ChrisChrisLoLo/bancouver40/firmware/README.md

# Firmware
This is the default firmware used for the bancouver40. It comes with the [TypeBeastXDPlus Home Edition layout](https://github.com/ChrisChrisLoLo/TypeBeastXDPlus) pre-installed.

If you wish to customize the layout, you can find the QMK source code here: https://github.com/ChrisChrisLoLo/qmk_firmware/tree/bancouver40/keyboards/sporewoh/bancouver40

# Vial
Please use the hex files labelled `vial`. You can find the source files of the vial configuration code here: https://github.com/ChrisChrisLoLo/vial-qmk/tree/sporewoh/keyboards/sporewoh

# QMK Toolbox
When using the vial images via QMK Toolbox, please press the reset button, then press `Clear EEPROM` before clicking on `Flash`. Your keyboard might otherwise not be responsive (but can still be reflashed and retried again).

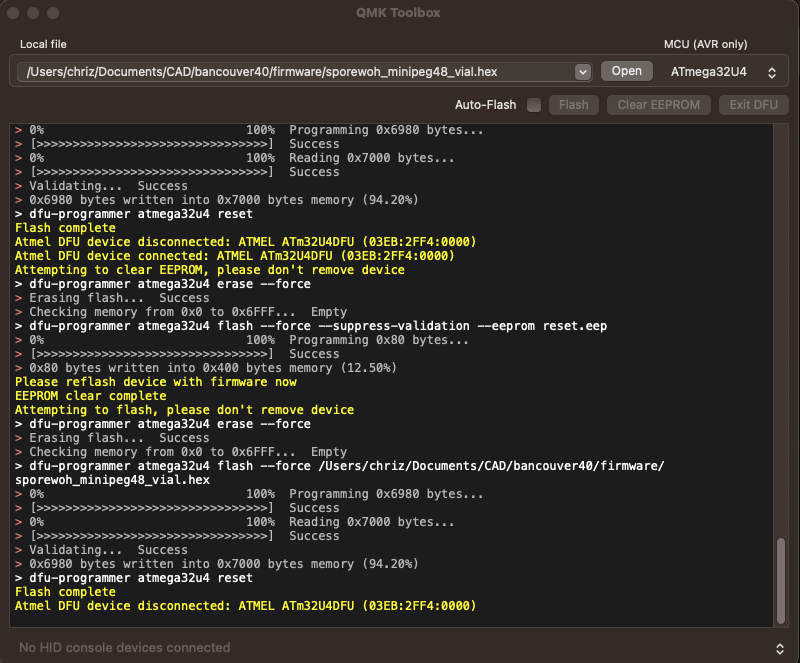
[picture p1: images/Screenshot 2023-12-05 at 7.41.32 PM.png]
image illustrating how to use QMK Toolbox
