ChrisChrisLoLo/bancouver40/images/PXL_20221205_012230895-01.jpeg

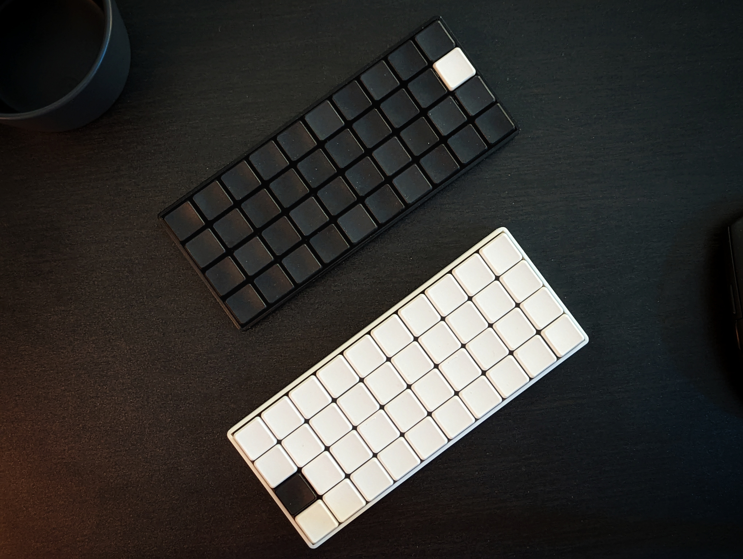
images/PXL_20221205_012230895-01.jpeg
