ChrisChrisLoLo/bancouver40/images/PXL_20221205_012951007-01.jpeg

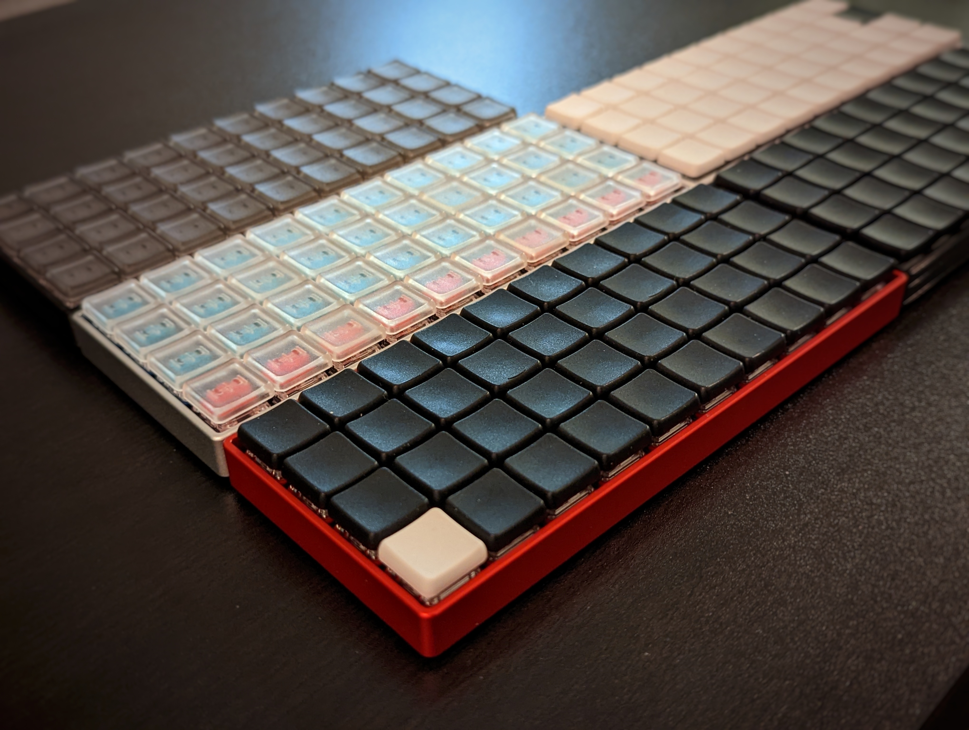
images/PXL_20221205_012951007-01.jpeg
