ChrisChrisLoLo/bancouver40/images/PXL_20221205_015210392-01.jpeg

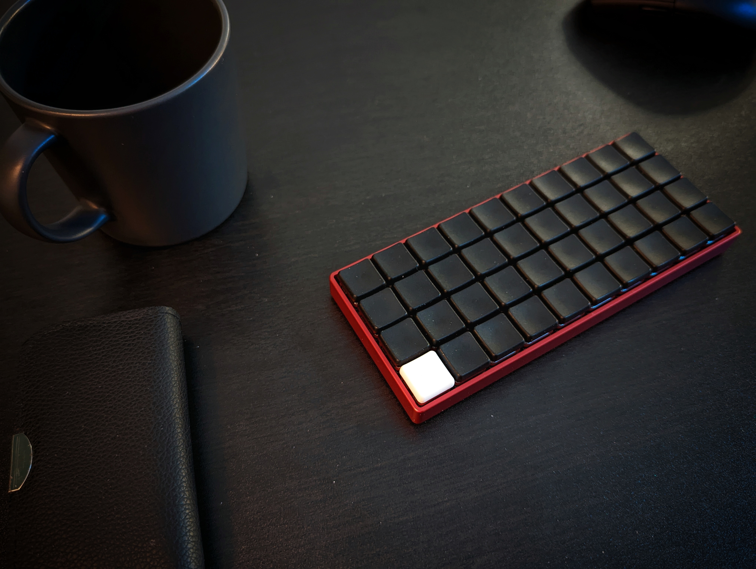
images/PXL_20221205_015210392-01.jpeg
