ChrisChrisLoLo/bancouver40/images/PXL_20231022_023334208.jpg

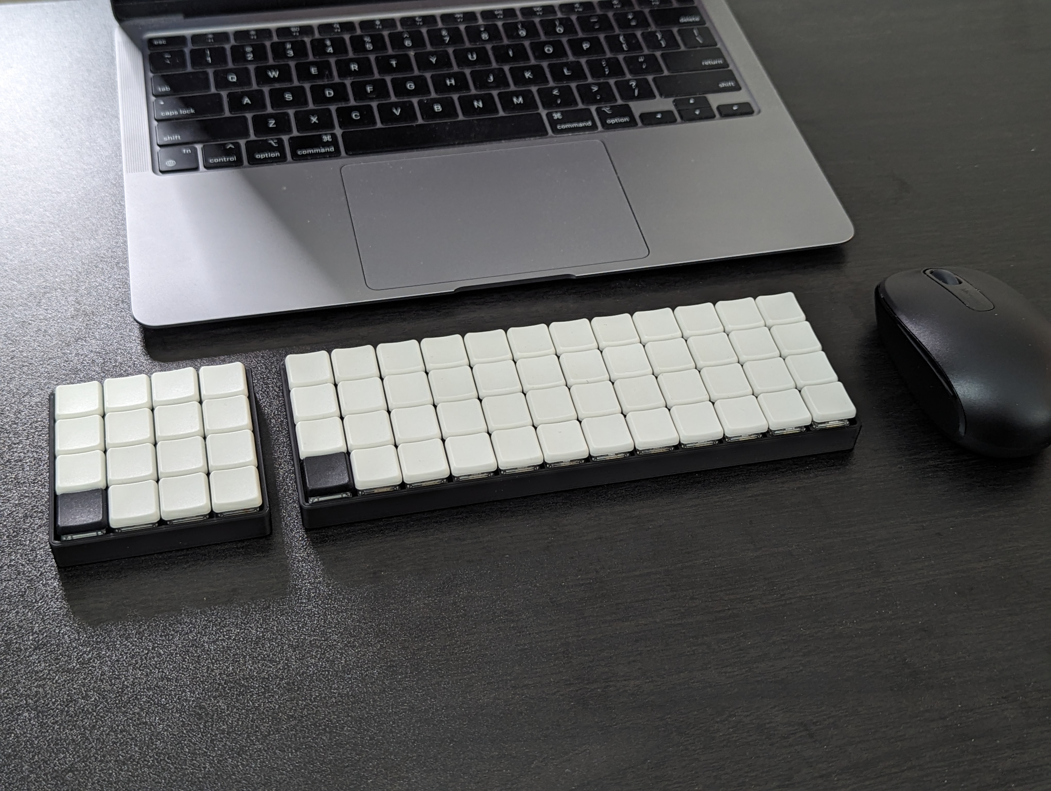
images/PXL_20231022_023334208.jpg
