ChrisChrisLoLo/bancouver40/case/cnc/exports_v3/bancouver40_cnc_final_v3.step

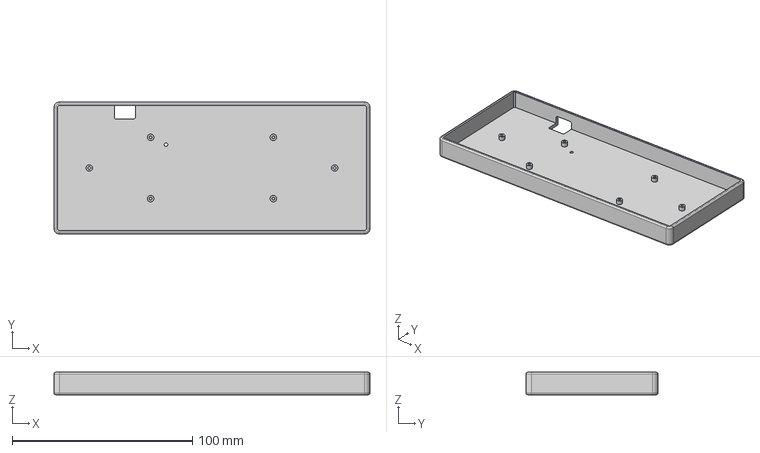
[picture p6: CAD file, 2022-12-05]
case/cnc/exports_v3/bancouver40_cnc_final_v3.step
175.2 x 73.2 x 12.5 mm
