ChrisChrisLoLo/bancouver40/kowgary16/kowgary_16_cnc/C-H27W463833A_kowgary16 cnc final v3.step

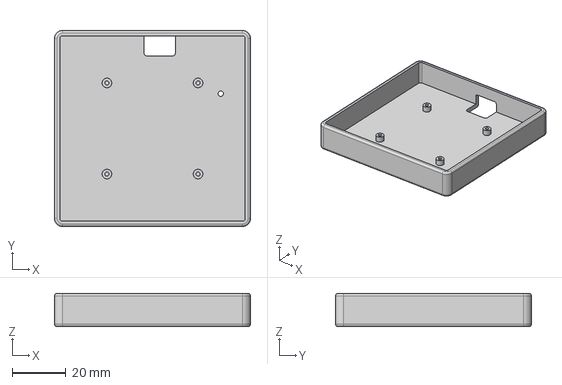
[picture p7: CAD file, 2023-10-22]
kowgary16/kowgary_16_cnc/C-H27W463833A_kowgary16 cnc final v3.step
73.2 x 73.2 x 12.5 mm
