ChrisChrisLoLo/bancouver40/kowgary16/pcb/kowgary16_cfx/gerbers/kowgary16_cfx-PTH-drl-drl_map.dxf

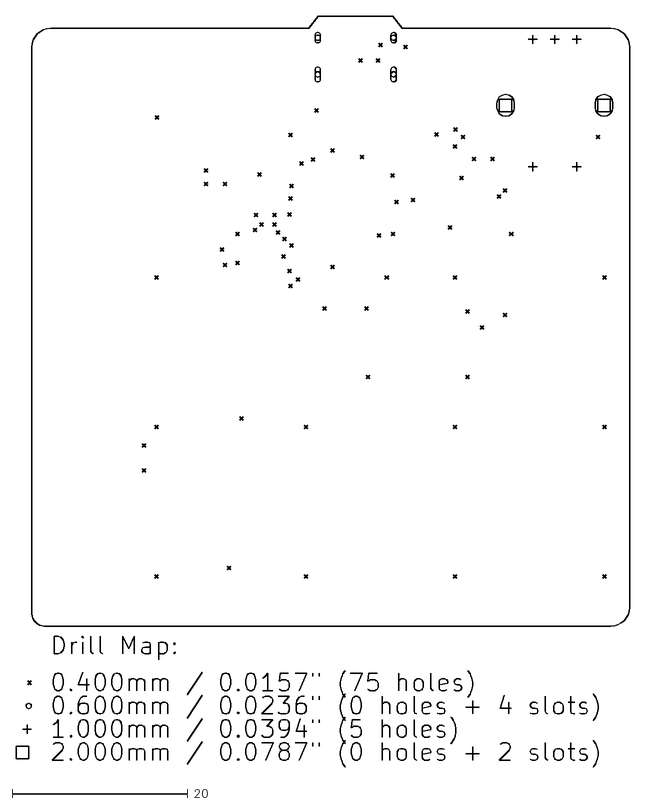
[picture p8: CAD file, 2023-10-22]
kowgary16/pcb/kowgary16_cfx/gerbers/kowgary16_cfx-PTH-drl-drl_map.dxf
69.8 x 85.5
