ChrisChrisLoLo/bancouver40/minipeg48/minipeg48/cnc/minipeg48 v2.step

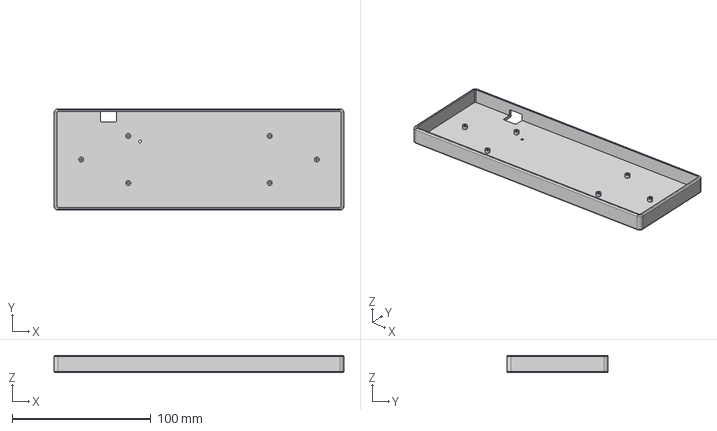
[picture p9: CAD file, 2023-10-22]
minipeg48/minipeg48/cnc/minipeg48 v2.step
209.2 x 73.2 x 12.5 mm
