ChrisChrisLoLo/bancouver40/minipeg48/outlines/plate-2022-10-21T02 10 11.128Z.dxf

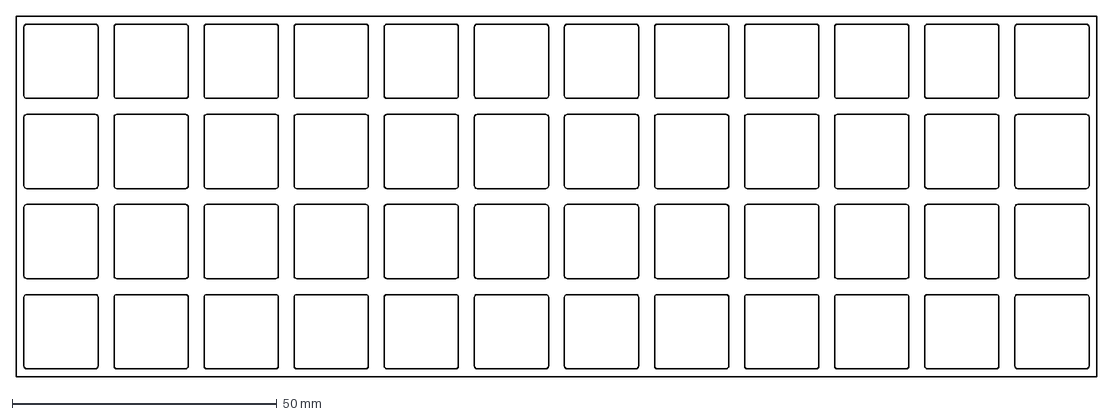
[picture p10: CAD file, 2023-10-22]
minipeg48/outlines/plate-2022-10-21T02 10 11.128Z.dxf
204.0 x 68.0 mm
