ChrisChrisLoLo/bancouver40/minipeg48/pcb/dogema48_cfx/gerbers/dogema48_cfx-NPTH-drl-drl_map.dxf

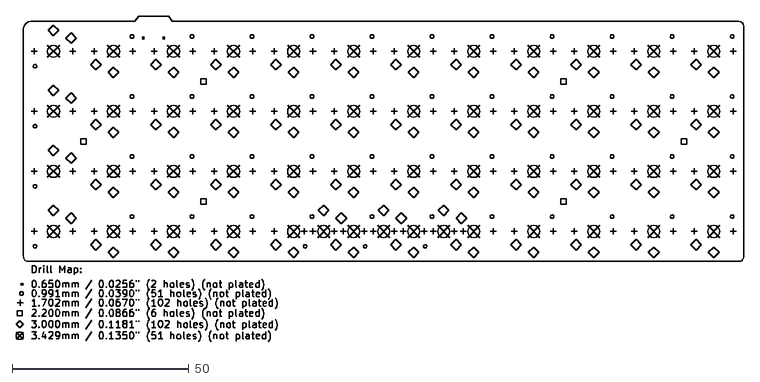
[picture p11: CAD file, 2023-10-22]
minipeg48/pcb/dogema48_cfx/gerbers/dogema48_cfx-NPTH-drl-drl_map.dxf
206.1 x 92.1
