ChrisChrisLoLo/bancouver40/outlines/cfx_spacing/plate-2022-10-10T04 27 35.834Z.dxf

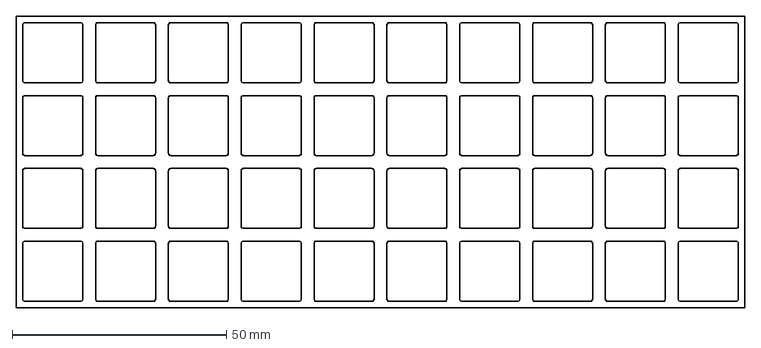
[picture p12: CAD file, 2022-10-11]
outlines/cfx_spacing/plate-2022-10-10T04 27 35.834Z.dxf
170.0 x 68.0 mm
