ChrisChrisLoLo/bancouver40/outlines/choc_spacing/plate-2022-10-10T15 28 30.631Z.dxf

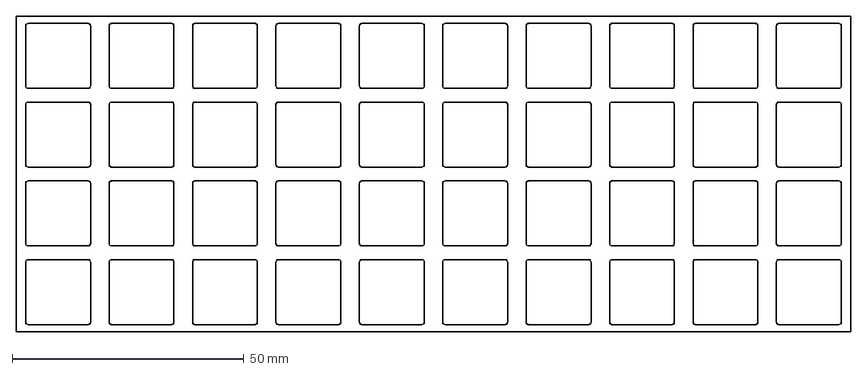
[picture p13: CAD file, 2022-10-11]
outlines/choc_spacing/plate-2022-10-10T15 28 30.631Z.dxf
180.0 x 68.0 mm
