ChrisChrisLoLo/bancouver40/pcb/bancouver40_cfx/gerbers-cam350/bancouver40_cfx-B_Cu.dxf

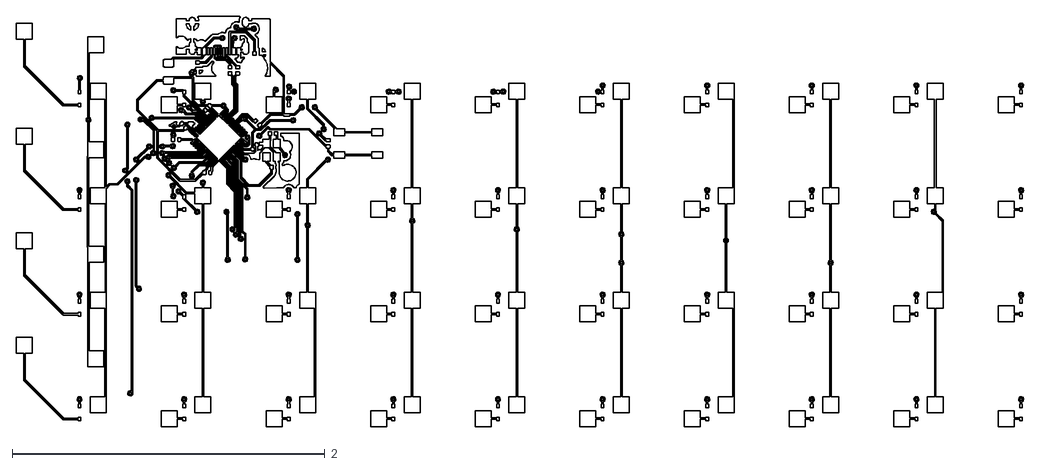
[picture p14: CAD file, 2023-10-22]
pcb/bancouver40_cfx/gerbers-cam350/bancouver40_cfx-B_Cu.dxf
6.44 x 2.62
