ChrisChrisLoLo/bancouver40/kowgary16/pcb/kowgary16_cfx/gerbers/kowgary16_cfx-NPTH-drl-drl_map.dxf

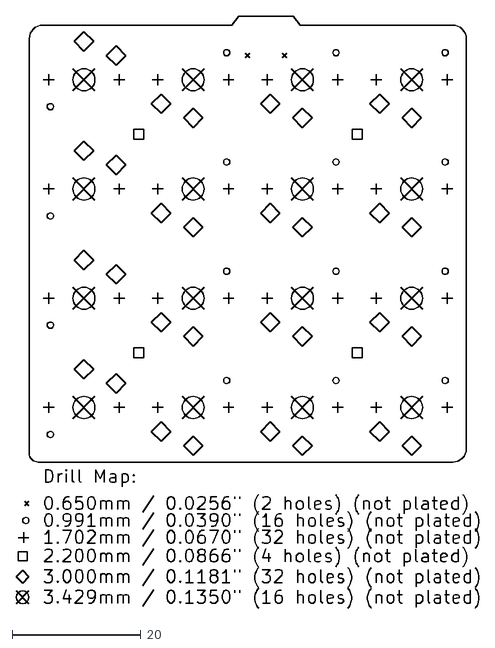
[picture p15: CAD file, 2023-10-22]
kowgary16/pcb/kowgary16_cfx/gerbers/kowgary16_cfx-NPTH-drl-drl_map.dxf
72.0 x 92.1
