ChrisChrisLoLo/bancouver40/minipeg48/pcb/dogema48_cfx/gerbers/dogema48_cfx-B_Cu.dxf

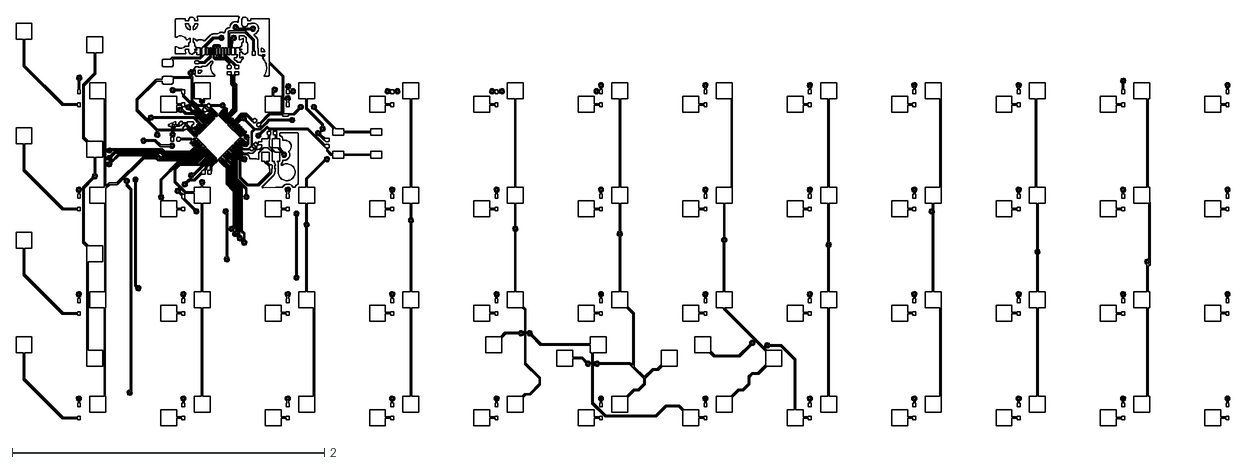
[picture p16: CAD file, 2023-10-22]
minipeg48/pcb/dogema48_cfx/gerbers/dogema48_cfx-B_Cu.dxf
7.78 x 2.62
