ChrisChrisLoLo/bancouver40/pcb/bancouver40_cfx/gerbers-cam350/bancouver40_cfx-F_Cu.dxf

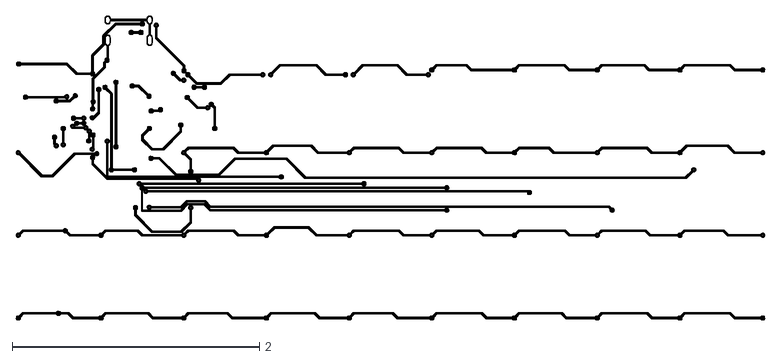
[picture p17: CAD file, 2023-10-22]
pcb/bancouver40_cfx/gerbers-cam350/bancouver40_cfx-F_Cu.dxf
6.06 x 2.46
