ChrisChrisLoLo/bancouver40/kowgary16/pcb/kowgary16_cfx/gerbers/kowgary16_cfx-Edge_Cuts.dxf

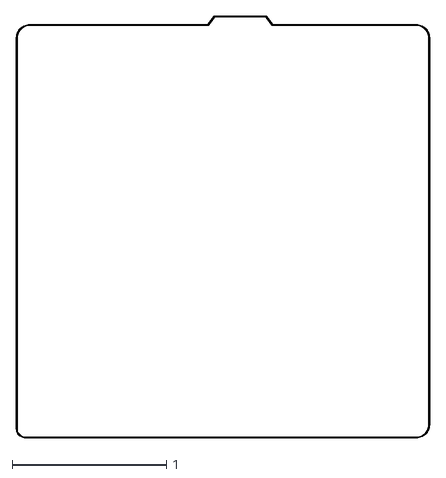
[picture p18: CAD file, 2023-10-22]
kowgary16/pcb/kowgary16_cfx/gerbers/kowgary16_cfx-Edge_Cuts.dxf
2.68 x 2.74
