ChrisChrisLoLo/bancouver40/minipeg48/pcb/dogema48_cfx/gerbers/dogema48_cfx-F_Cu.dxf

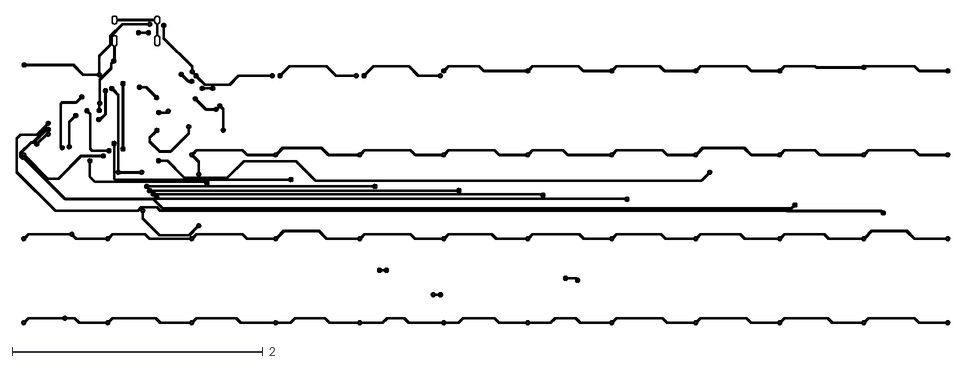
[picture p19: CAD file, 2023-10-22]
minipeg48/pcb/dogema48_cfx/gerbers/dogema48_cfx-F_Cu.dxf
7.44 x 2.46
