ChrisChrisLoLo/bancouver40/pcb/bancouver40_cfx/gerbers-cam350/bancouver40_cfx-Edge_Cuts.dxf

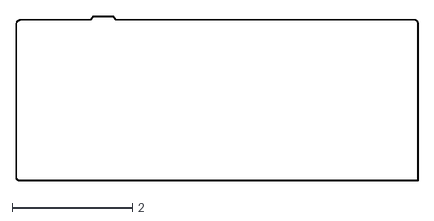
[picture p20: CAD file, 2023-10-22]
pcb/bancouver40_cfx/gerbers-cam350/bancouver40_cfx-Edge_Cuts.dxf
6.70 x 2.74
