ChrisChrisLoLo/bancouver40/kowgary16/pcb/kowgary16_cfx/gerbers/kowgary16_cfx-F_Cu.dxf

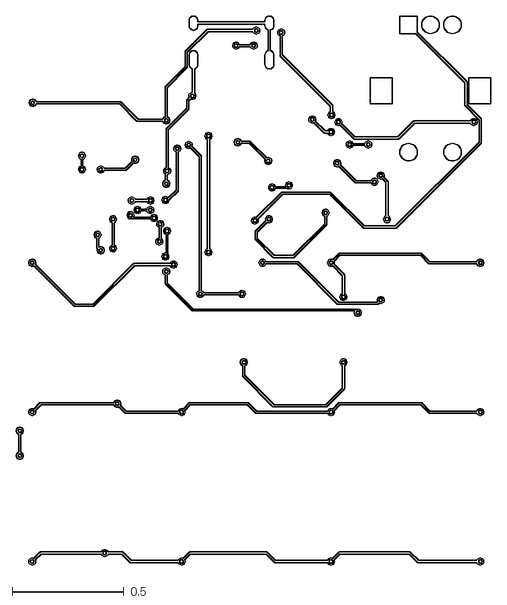
[picture p21: CAD file, 2023-10-22]
kowgary16/pcb/kowgary16_cfx/gerbers/kowgary16_cfx-F_Cu.dxf
2.13 x 2.46
