ChrisChrisLoLo/bancouver40/minipeg48/pcb/dogema48_cfx/gerbers/dogema48_cfx-PTH-drl-drl_map.dxf

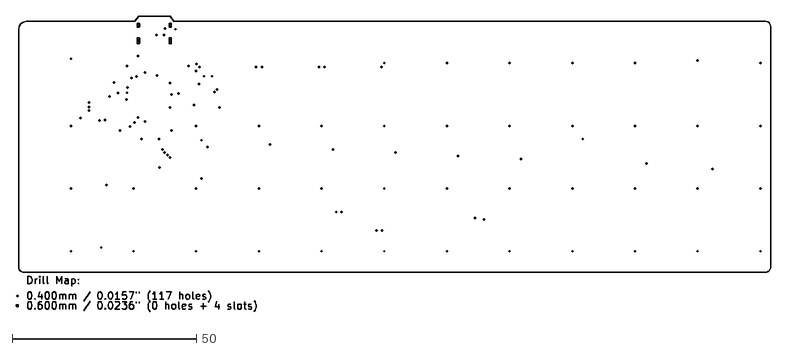
[picture p22: CAD file, 2023-10-22]
minipeg48/pcb/dogema48_cfx/gerbers/dogema48_cfx-PTH-drl-drl_map.dxf
204.6 x 80.2
