ChrisChrisLoLo/bancouver40/kowgary16/pcb/kowgary16_cfx/gerbers/kowgary16_cfx-B_Cu.dxf

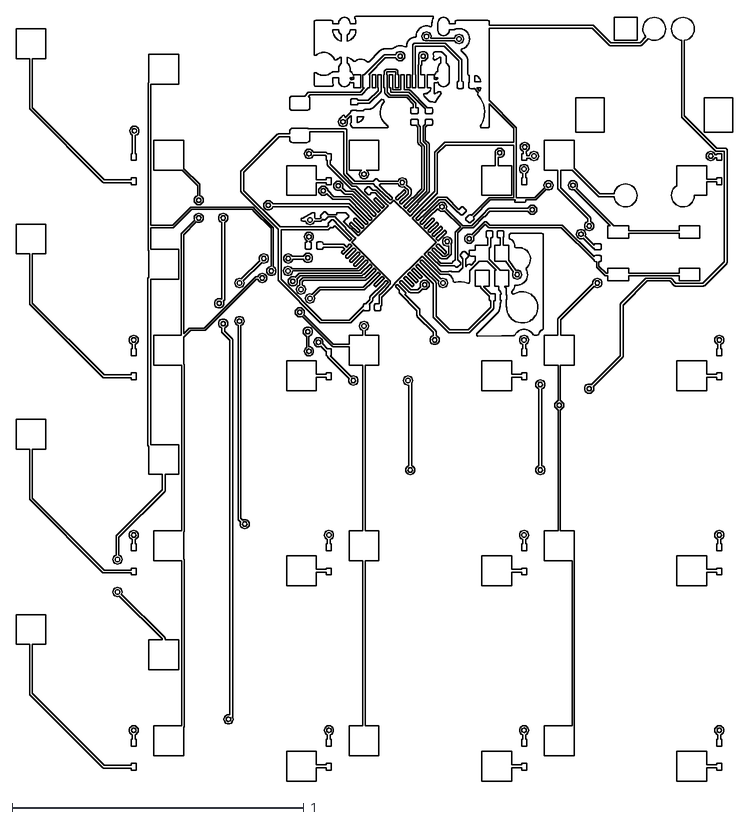
[picture p23: CAD file, 2023-10-22]
kowgary16/pcb/kowgary16_cfx/gerbers/kowgary16_cfx-B_Cu.dxf
2.46 x 2.62
