ChrisChrisLoLo/bancouver40/minipeg48/pcb/dogema48_cfx/gerbers/dogema48_cfx-Edge_Cuts.dxf

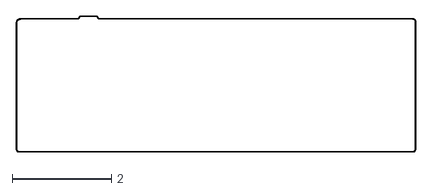
[picture p24: CAD file, 2023-10-22]
minipeg48/pcb/dogema48_cfx/gerbers/dogema48_cfx-Edge_Cuts.dxf
8.04 x 2.74
