ChrisChrisLoLo/bancouver40/case/cnc/bancouver40_3DP_Case.stl

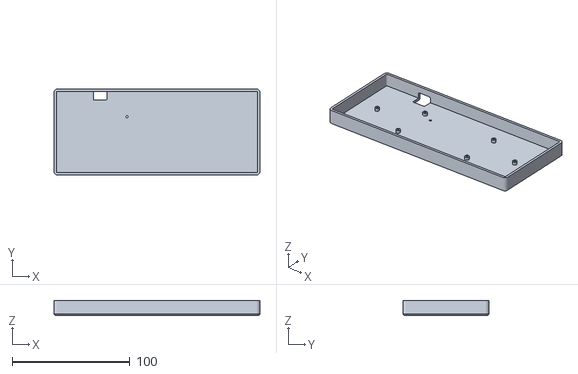
[picture p25: CAD file, 2022-12-05]
case/cnc/bancouver40_3DP_Case.stl
175.2 x 73.2 x 12.5
