ChrisChrisLoLo/bancouver40/(list of files, cad)

Other CAD files:
case/cnc/keezyBoost40Case.stl
case/cnc/bancouver40 3dp v9.stl
case/cnc/bancouver40 cnc v6 control group.step
case/cnc/bancouver40 cnc v6.3mf
case/cnc/bancouver40 3dp v12.step
case/cnc/bancouver40 3dp v1.stl
case/cnc/bancouver40 3dp v10.step
case/cnc/bancouver40 3dp v2.stl
case/cnc/bancouver40 cnc final v2.step
case/cnc/bancouver40 cnc v6.stl
kowgary16/pcb/kowgary16_cfx/gerbers/kowgary16_cfx-B_Mask.dxf
kowgary16/pcb/kowgary16_cfx/gerbers/kowgary16_cfx-B_Paste.dxf
kowgary16/pcb/kowgary16_cfx/gerbers/kowgary16_cfx-B_Silkscreen.dxf
kowgary16/pcb/kowgary16_cfx/gerbers/kowgary16_cfx-F_Mask.dxf
kowgary16/pcb/kowgary16_cfx/gerbers/kowgary16_cfx-F_Paste.dxf
kowgary16/pcb/kowgary16_cfx/gerbers/kowgary16_cfx-F_Silkscreen.dxf
minipeg48/pcb/dogema48_cfx/gerbers/dogema48_cfx-B_Mask.dxf
minipeg48/pcb/dogema48_cfx/gerbers/dogema48_cfx-B_Paste.dxf
minipeg48/pcb/dogema48_cfx/gerbers/dogema48_cfx-B_Silkscreen.dxf
minipeg48/pcb/dogema48_cfx/gerbers/dogema48_cfx-F_Mask.dxf
minipeg48/pcb/dogema48_cfx/gerbers/dogema48_cfx-F_Paste.dxf
minipeg48/pcb/dogema48_cfx/gerbers/dogema48_cfx-F_Silkscreen.dxf
pcb/bancouver40_cfx/gerbers-cam350/bancouver40_cfx-B_Mask.dxf
pcb/bancouver40_cfx/gerbers-cam350/bancouver40_cfx-B_Paste.dxf
pcb/bancouver40_cfx/gerbers-cam350/bancouver40_cfx-B_Silkscreen.dxf
pcb/bancouver40_cfx/gerbers-cam350/bancouver40_cfx-F_Mask.dxf
pcb/bancouver40_cfx/gerbers-cam350/bancouver40_cfx-F_Paste.dxf
pcb/bancouver40_cfx/gerbers-cam350/bancouver40_cfx-F_Silkscreen.dxf
