ChrisChrisLoLo/bancouver40/kowgary16/kowgary_16_cnc/kowgary16 cnc final Drawing v2.pdf

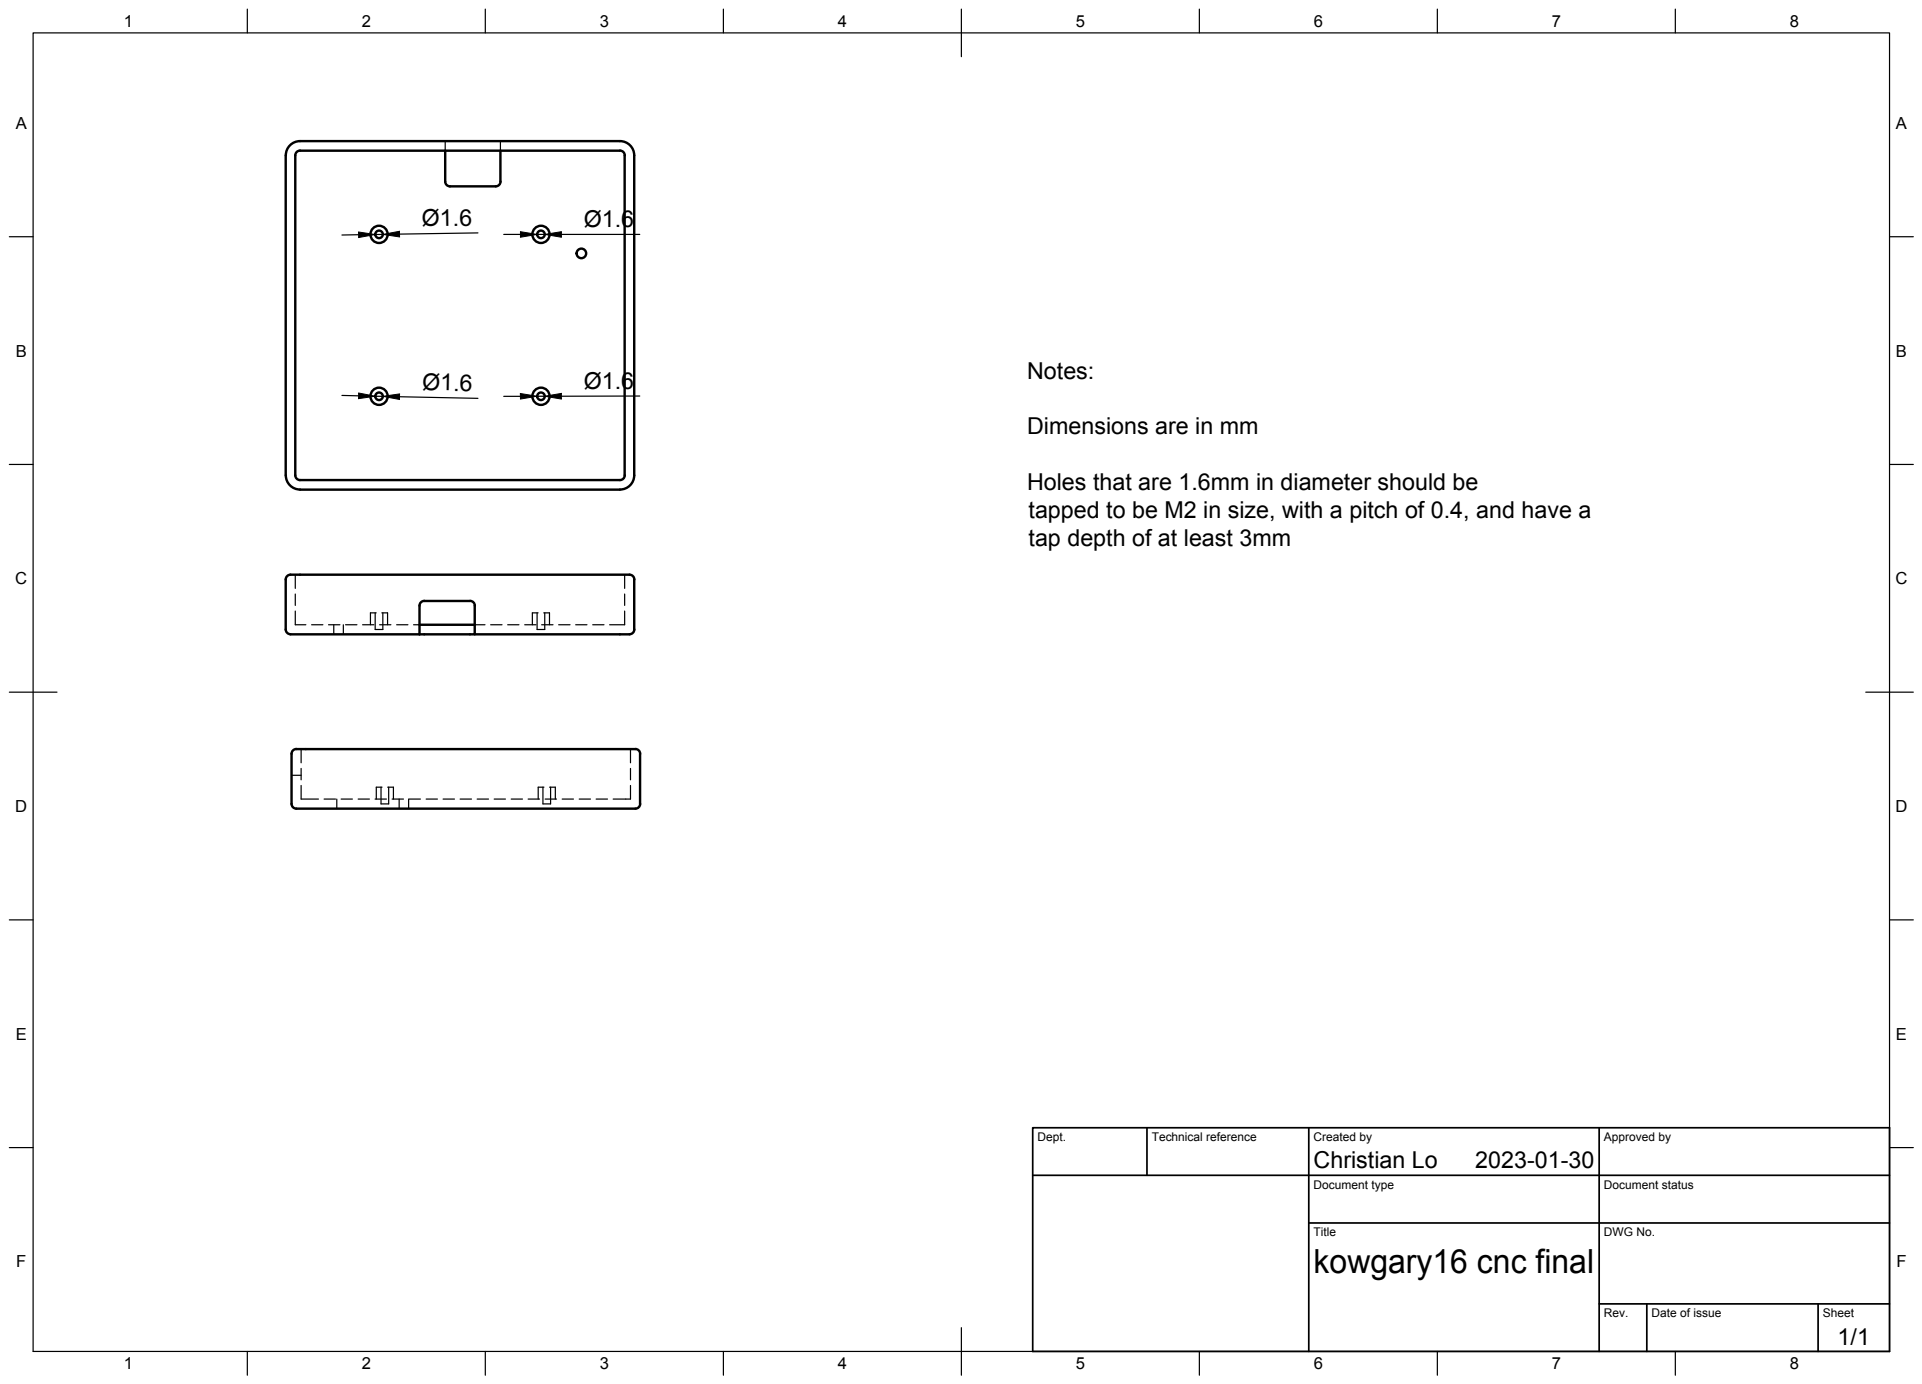
[picture p26: page 1]
Title; DWG No.; Rev.; Date of issue; Sheet; kowgary16 cnc final

Dimensions are in mm

Holes that are 1.6mm in diameter should be
tapped to be M2 in size, with a pitch of 0.4, and have a
tap depth of at least 3mm

Dept. | Technical reference | Created by Christian Lo 2023-01-30 | Approved by

Document type | Document status
