ChrisChrisLoLo/bancouver40/case/cnc/bancouver40 cnc final Drawing v3.pdf

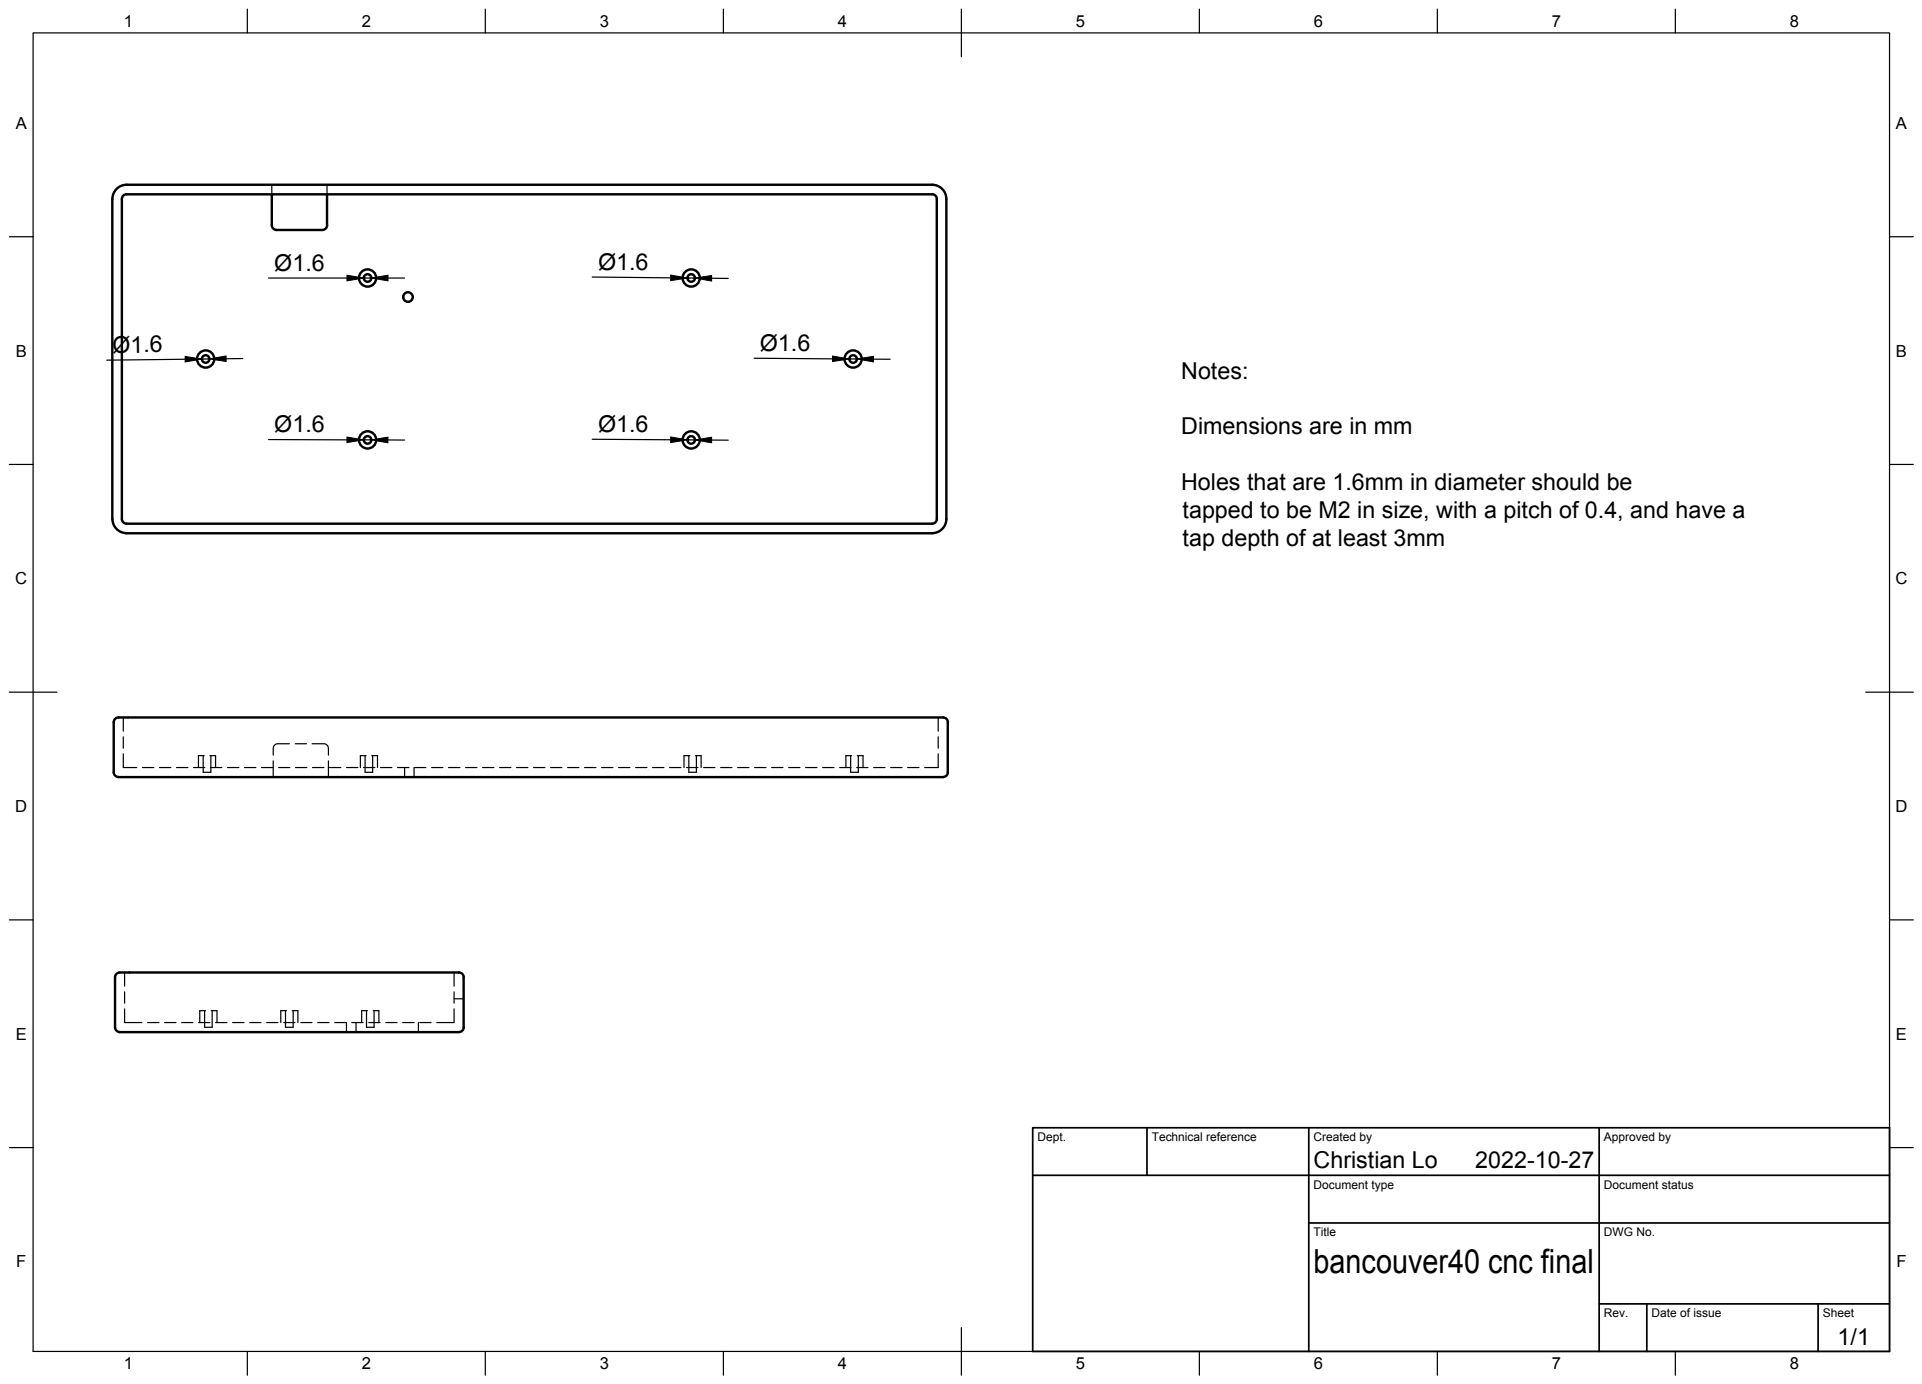
[picture p27: page 1]
Title; DWG No.; Rev.; Date of issue; Sheet; bancouver40 cnc final

Dimensions are in mm

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

Dept. | Technical reference | Created by Christian Lo 2022-10-27 | Approved by

Document type | Document status
