ChrisChrisLoLo/bancouver40/kowgary16/pcb/kowgary16_cfx/schematic.pdf

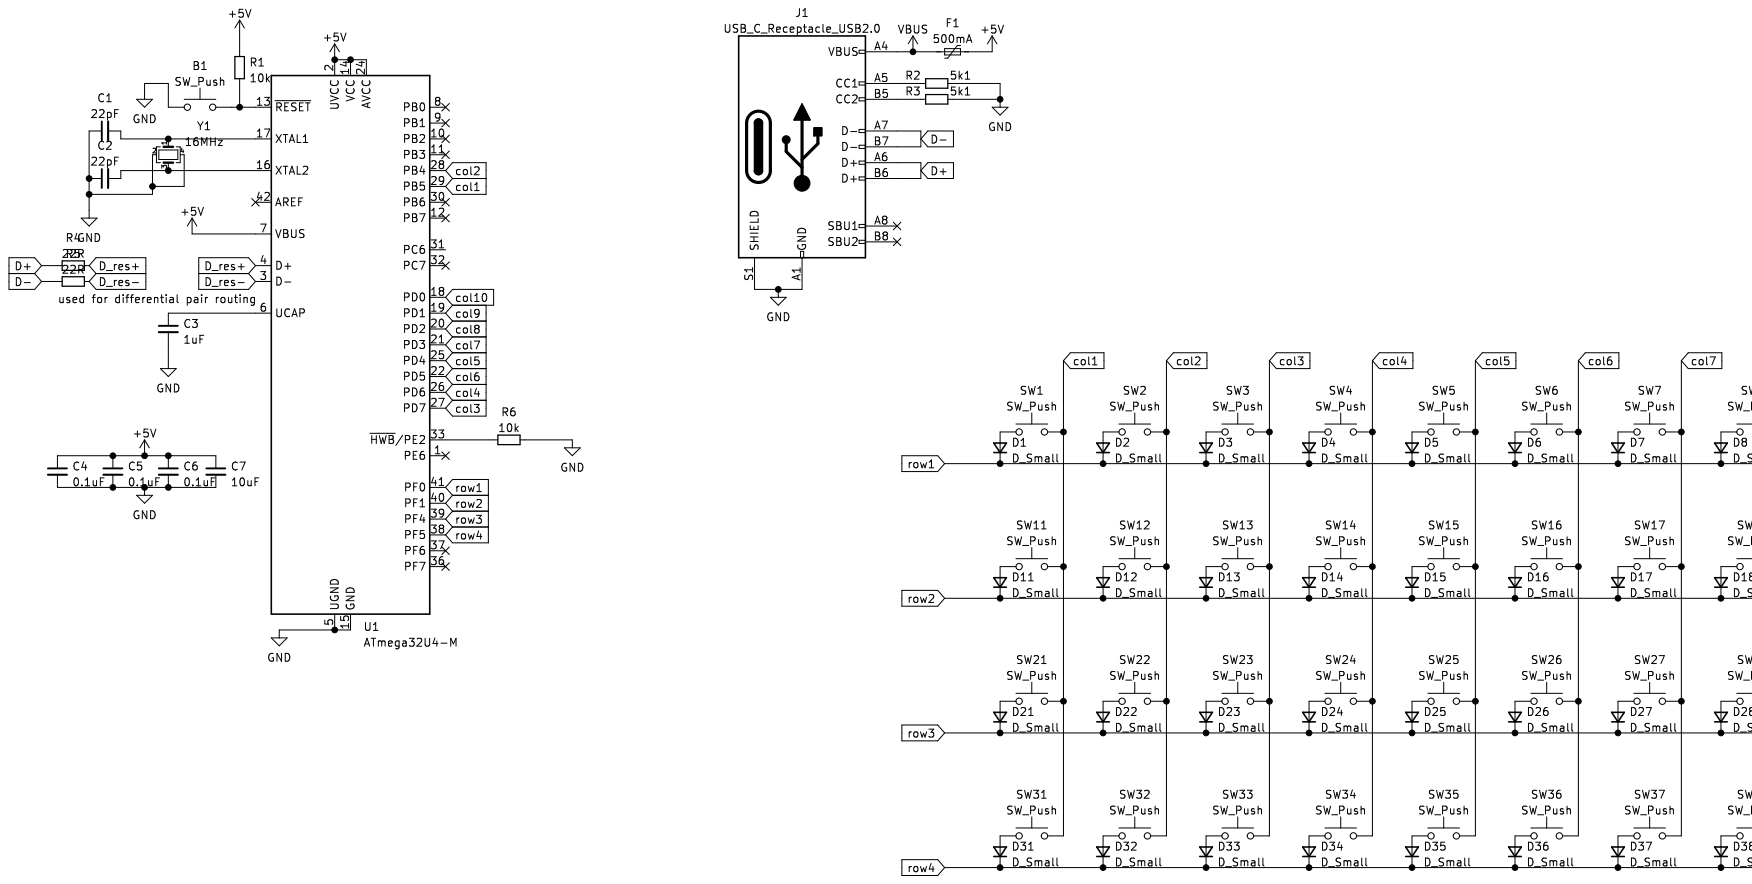
[picture p28: page 1]
