ChrisChrisLoLo/bancouver40/minipeg48/pcb/dogema48_cfx/dogema48_cfx.kicad_pcb

## KiCad design minipeg48/pcb/dogema48_cfx/dogema48_cfx.kicad_pcb (2023-10-22)

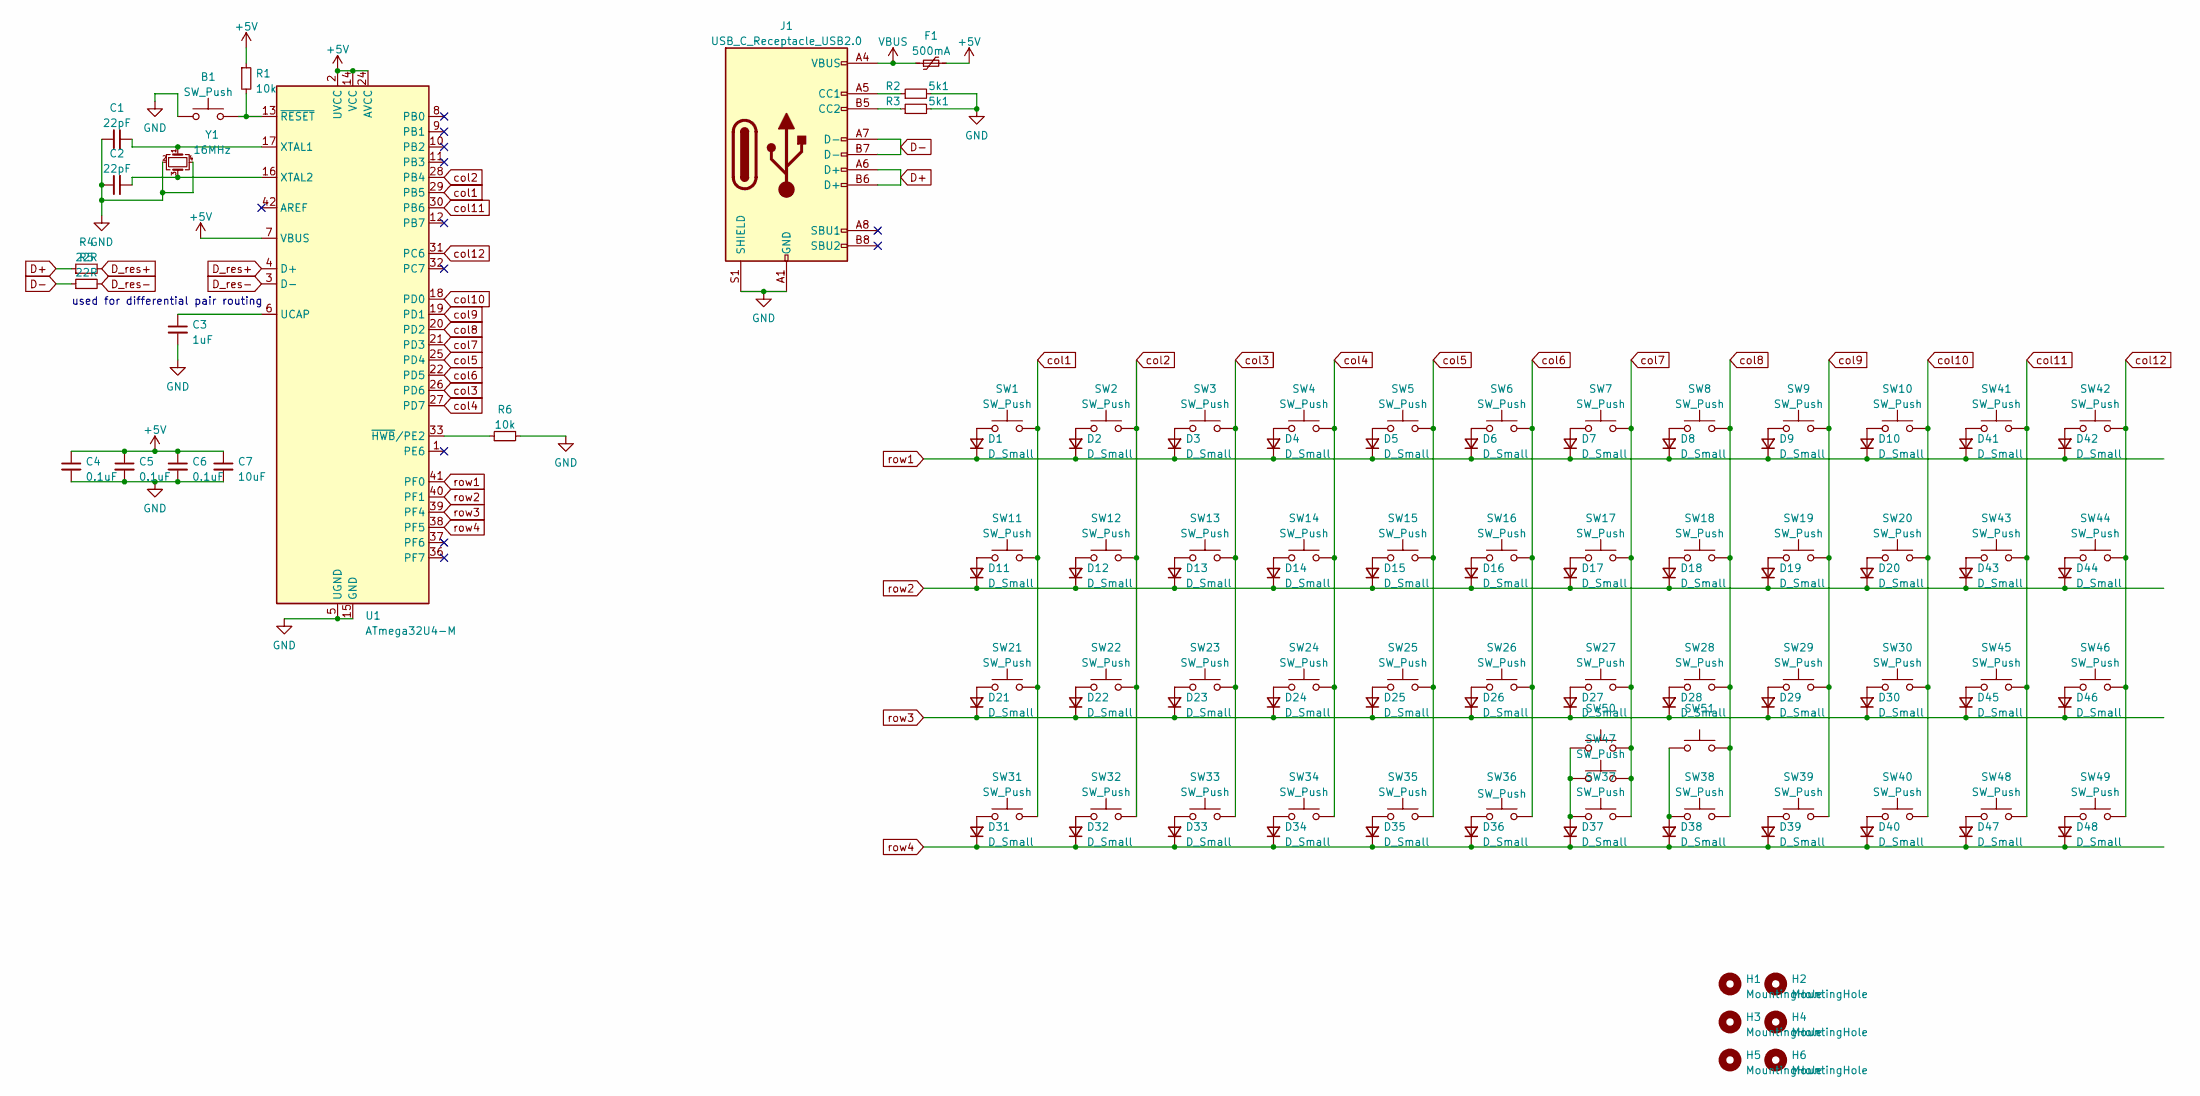
[picture p29: schematic dogema48_cfx.kicad_sch]

Parts:
B1: SW_Push; SW_SPST_SKQG_WithoutStem
C1, C2: 22pF; C_0402_1005Metric
C3: 1uF; C_0402_1005Metric
C4, C5, C6: 0.1uF; C_0402_1005Metric
C7: 10uF; C_0402_1005Metric
D1, D2, D3, D4, D5, D6, D7, D8, D9, D10, D11, D12, D13, D14, D15, D16, D17, D18, D19, D20, D21, D22, D23, D24, D25, D26, D27, D28, D29, D30, D31, D32, D33, D34, D35, D36, D37, D38, D39, D40, D41, D42, D43, D44, D45, D46, D47, D48: D_Small; D_SOD-323
F1: 500mA; Fuse_1206_3216Metric
H1, H2, H3, H4, H5, H6: MountingHole; MountingHole_2.2mm_M2_ISO7380
J1: USB_C_Receptacle_USB2.0; USB_C_Receptacle_XKB_U262-16XN-4BVC11
R1, R6: 10k; R_0402_1005Metric
R2, R3: 5k1; R_0402_1005Metric
R4, R5: 22R; R_0402_1005Metric
SW1, SW2, SW3, SW4, SW5, SW6, SW7, SW8, SW9, SW10, SW11, SW12, SW13, SW14, SW15, SW16, SW17, SW18, SW19, SW20, SW21, SW22, SW23, SW24, SW25, SW26, SW27, SW28, SW29, SW30, SW31, SW32, SW33, SW34, SW35, SW36, SW37, SW38, SW39, SW40, SW41, SW42, SW43, SW44, SW45, SW46, SW47, SW48, SW49: SW_Push; Kailh_socket_PG1350
SW50, SW51: (no value)
U1: ATmega32U4-M; QFN-44-1EP_7x7mm_P0.5mm_EP5.2x5.2mm
Y1: 16MHz; Crystal_SMD_3225-4Pin_3.2x2.5mm

Connections:
+5V: C4.1, C5.1, C6.1, C7.1, F1.2, R1.1, U1.2 (UVCC), U1.7 (VBUS), U1.14 (VCC), U1.24 (AVCC), U1.34 (VCC), U1.44 (AVCC)
D+: J1.A6 (D+), J1.B6 (D+), R4.1
D-: J1.A7 (D-), J1.B7 (D-), R5.1
D_res+: R4.2, U1.4 (D+)
D_res-: R5.2, U1.3 (D-)
GND: B1.1, C1.1, C2.1, C3.2, C4.2, C5.2, C6.2, C7.2, J1.A1 (GND), J1.A12 (GND), J1.B1 (GND), J1.B12 (GND), J1.S1 (SHIELD), R2.2, R3.2, R6.2, U1.5 (UGND), U1.15 (GND), U1.23 (GND), U1.35 (GND), U1.43 (GND), U1.45 (GND), Y1.2, Y1.4
unnamed: B1.2, R1.2, U1.13 (~RESET)
unnamed: C1.2, U1.17 (XTAL1), Y1.1
unnamed: C2.2, U1.16 (XTAL2), Y1.3
unnamed: C3.1, U1.6 (UCAP)
unnamed: D1.2 (A), SW1.1
unnamed: D2.2 (A), SW2.1
unnamed: D3.2 (A), SW3.1
unnamed: D4.2 (A), SW4.1
unnamed: D5.2 (A), SW5.1
unnamed: D6.2 (A), SW6.1
unnamed: D7.2 (A), SW7.1
unnamed: D8.2 (A), SW8.1
unnamed: D9.2 (A), SW9.1
unnamed: D10.2 (A), SW10.1
unnamed: D11.2 (A), SW11.1
unnamed: D12.2 (A), SW12.1
unnamed: D13.2 (A), SW13.1
unnamed: D14.2 (A), SW14.1
unnamed: D15.2 (A), SW15.1
unnamed: D16.2 (A), SW16.1
unnamed: D17.2 (A), SW17.1
unnamed: D18.2 (A), SW18.1
unnamed: D19.2 (A), SW19.1
unnamed: D20.2 (A), SW20.1
unnamed: D21.2 (A), SW21.1
unnamed: D22.2 (A), SW22.1
unnamed: D23.2 (A), SW23.1
unnamed: D24.2 (A), SW24.1
unnamed: D25.2 (A), SW25.1
unnamed: D26.2 (A), SW26.1
unnamed: D27.2 (A), SW27.1
unnamed: D28.2 (A), SW28.1
unnamed: D29.2 (A), SW29.1
unnamed: D30.2 (A), SW30.1
unnamed: D31.2 (A), SW31.1
unnamed: D32.2 (A), SW32.1
unnamed: D33.2 (A), SW33.1
unnamed: D34.2 (A), SW34.1
unnamed: D35.2 (A), SW35.1
unnamed: D36.2 (A), SW36.1
unnamed: D37.2 (A), SW37.1, SW47.1, SW50.1
unnamed: D38.2 (A), SW38.1, SW51.1
unnamed: D39.2 (A), SW39.1
unnamed: D40.2 (A), SW40.1
unnamed: D41.2 (A), SW41.1
unnamed: D42.2 (A), SW42.1
unnamed: D43.2 (A), SW43.1
unnamed: D44.2 (A), SW44.1
unnamed: D45.2 (A), SW45.1
unnamed: D46.2 (A), SW46.1
unnamed: D47.2 (A), SW48.1
unnamed: D48.2 (A), SW49.1
unnamed: J1.A5 (CC1), R2.1
unnamed: J1.B5 (CC2), R3.1
unnamed: R6.1, U1.33 (~HWB/PE2)
VBUS: F1.1, J1.A4 (VBUS), J1.A9 (VBUS), J1.B4 (VBUS), J1.B9 (VBUS)
col1: SW1.2, SW11.2, SW21.2, SW31.2, U1.29 (PB5)
col2: SW2.2, SW12.2, SW22.2, SW32.2, U1.28 (PB4)
col3: SW3.2, SW13.2, SW23.2, SW33.2, U1.26 (PD6)
col4: SW4.2, SW14.2, SW24.2, SW34.2, U1.27 (PD7)
col5: SW5.2, SW15.2, SW25.2, SW35.2, U1.25 (PD4)
col6: SW6.2, SW16.2, SW26.2, SW36.2, U1.22 (PD5)
col7: SW7.2, SW17.2, SW27.2, SW37.2, SW47.2, SW50.2, U1.21 (PD3)
col8: SW8.2, SW18.2, SW28.2, SW38.2, SW51.2, U1.20 (PD2)
col9: SW9.2, SW19.2, SW29.2, SW39.2, U1.19 (PD1)
col10: SW10.2, SW20.2, SW30.2, SW40.2, U1.18 (PD0)
col11: SW41.2, SW43.2, SW45.2, SW48.2, U1.30 (PB6)
col12: SW42.2, SW44.2, SW46.2, SW49.2, U1.31 (PC6)
row1: D1.1 (K), D2.1 (K), D3.1 (K), D4.1 (K), D5.1 (K), D6.1 (K), D7.1 (K), D8.1 (K), D9.1 (K), D10.1 (K), D41.1 (K), D42.1 (K), U1.41 (PF0)
row2: D11.1 (K), D12.1 (K), D13.1 (K), D14.1 (K), D15.1 (K), D16.1 (K), D17.1 (K), D18.1 (K), D19.1 (K), D20.1 (K), D43.1 (K), D44.1 (K), U1.40 (PF1)
row3: D21.1 (K), D22.1 (K), D23.1 (K), D24.1 (K), D25.1 (K), D26.1 (K), D27.1 (K), D28.1 (K), D29.1 (K), D30.1 (K), D45.1 (K), D46.1 (K), U1.39 (PF4)
row4: D31.1 (K), D32.1 (K), D33.1 (K), D34.1 (K), D35.1 (K), D36.1 (K), D37.1 (K), D38.1 (K), D39.1 (K), D40.1 (K), D47.1 (K), D48.1 (K), U1.38 (PF5)

Notes on the sheet:
used for differential pair routing

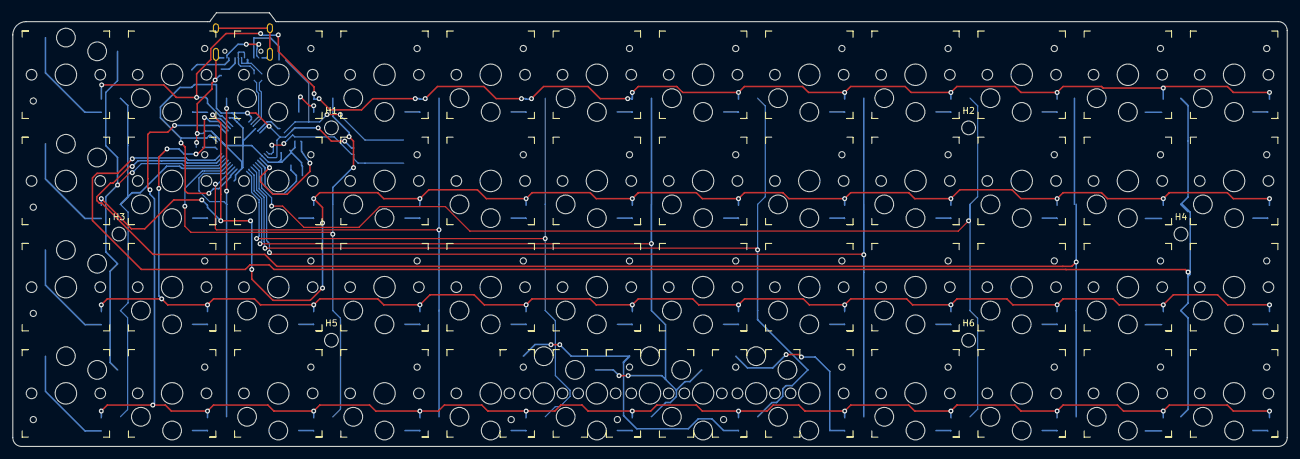
[picture p30: board dogema48_cfx.kicad_pcb from above]

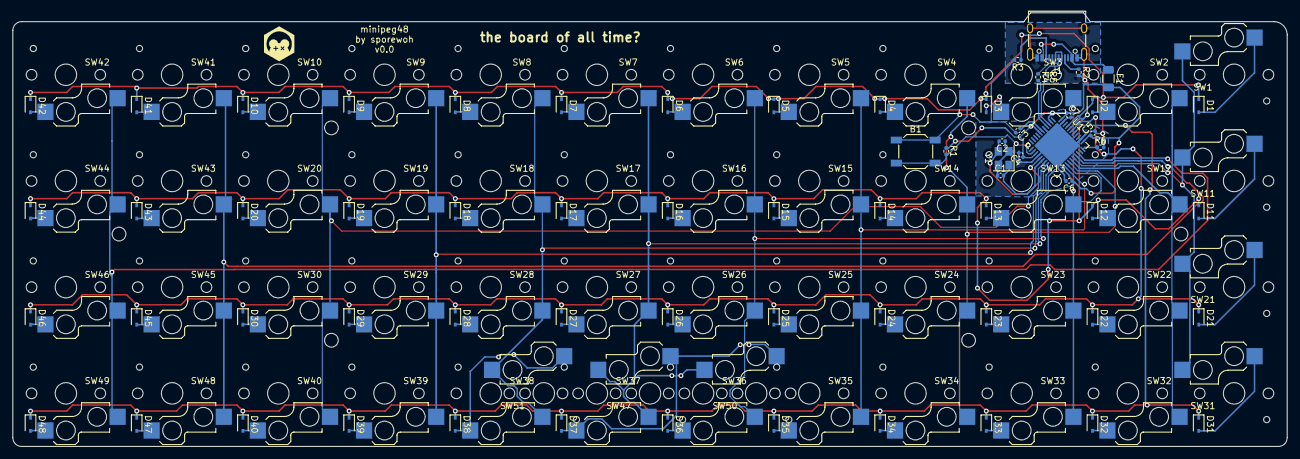
[picture p31: board dogema48_cfx.kicad_pcb from below]

Board: 2 copper layers, 204.0 x 69.4 mm, 123 parts (66 on the bottom side), 78 nets.
