ChrisChrisLoLo/bancouver40/(commit log)

2022-10-11 init commit
    [bancouver40_cfx-B_Cu.gbr, bancouver40_cfx-B_Mask.gbr, bancouver40_cfx-B_Paste.gbr, bancouver40_cfx-B_Silkscreen.gbr, bancouver40_cfx-Edge_Cuts.gbr, bancouver40_cfx-F_Cu.gbr, bancouver40_cfx-F_Mask.gbr, bancouver40_cfx-F_Paste.gbr]
2022-10-19 add gerbers
    [bancouver40_cfx-B_Cu.gbr, bancouver40_cfx-B_Mask.gbr, bancouver40_cfx-B_Paste.gbr, bancouver40_cfx-B_Silkscreen.gbr, bancouver40_cfx-Edge_Cuts.gbr, bancouver40_cfx-F_Cu.gbr, bancouver40_cfx-F_Mask.gbr, bancouver40_cfx-F_Paste.gbr]
2022-12-05 add case files
    [bancouver40 3dp v1.stl, bancouver40 3dp v10.step, bancouver40 3dp v12.step, bancouver40 3dp v2.stl, bancouver40 3dp v9.stl, bancouver40 cnc final v2.step, bancouver40 cnc final v3.step, bancouver40 cnc v6 control group.step]
2023-10-22 add minipeg48 and kowgary16
    [C-H27W463833A_kowgary16 cnc final v3.step, bancouver40_cfx-B_Cu.dxf, bancouver40_cfx-B_Mask.dxf, bancouver40_cfx-B_Paste.dxf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]
